simon-staal/Debonair/Energy/README.md

Energy
------

- [**Battery_Charge_Cycle_Logged_SoC**](Battery_Charge_Cycle_Logged_Soc) was used to measure SOC during discharge and charge cycle

- [**multi_Battery**](multi_battery) contains the charging and balancing program that was designed

- The matlab files contain various programs used to obtain graphs using data obtained from experiments

- [**sweep_currents**](sweep_currents) was used to obtain PV and IV curves from the solar panels
