simon-staal/Debonair/Energy/fsm.png

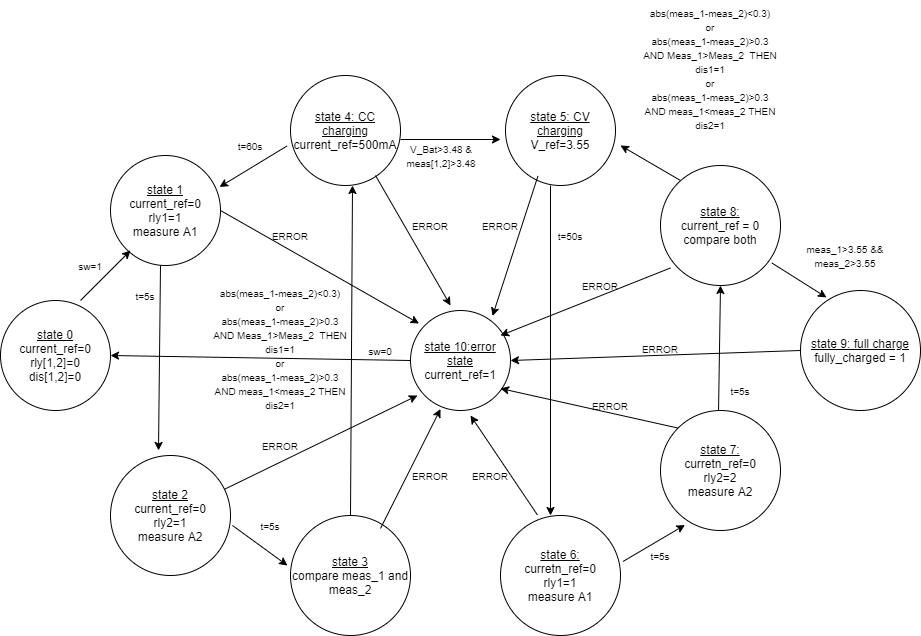
Energy/fsm.png
