simon-staal/Debonair/Front_End/React/web-app/src/components/background.jpg

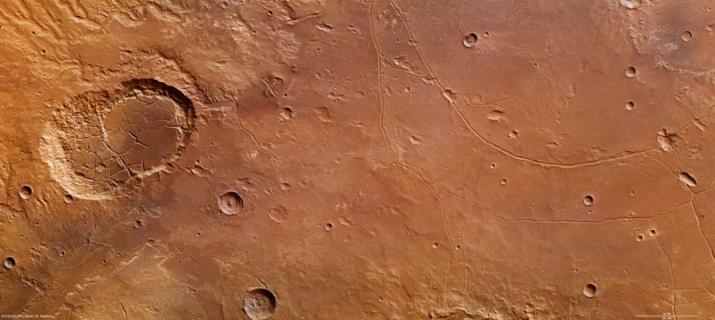
Front_End/React/web-app/src/components/background.jpg
