simon-staal/Debonair/Front_End/React/web-app/src/components/circle.png

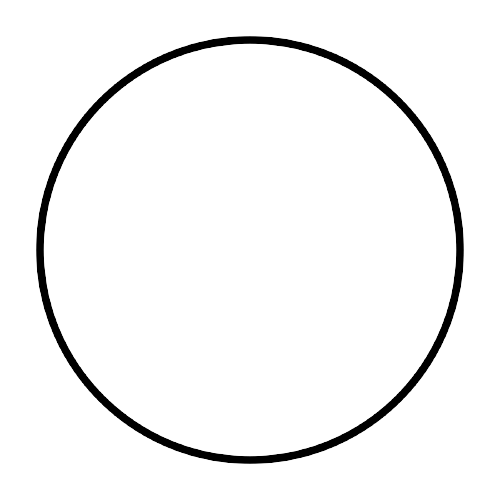
Front_End/React/web-app/src/components/circle.png
