simon-staal/Debonair/Front_End/React/web-app/src/components/grid.png

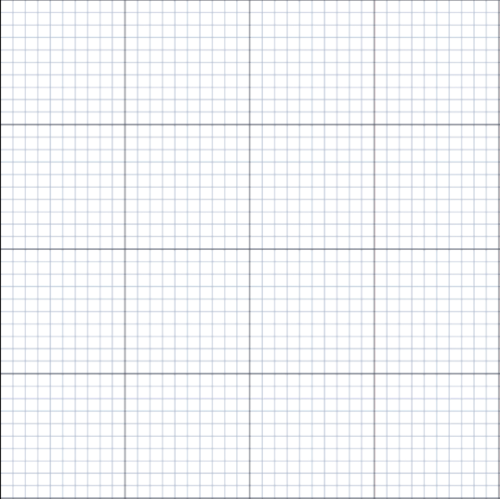
Front_End/React/web-app/src/components/grid.png
