simon-staal/Debonair/Front_End/React/web-app/src/components/grouppic.jpg

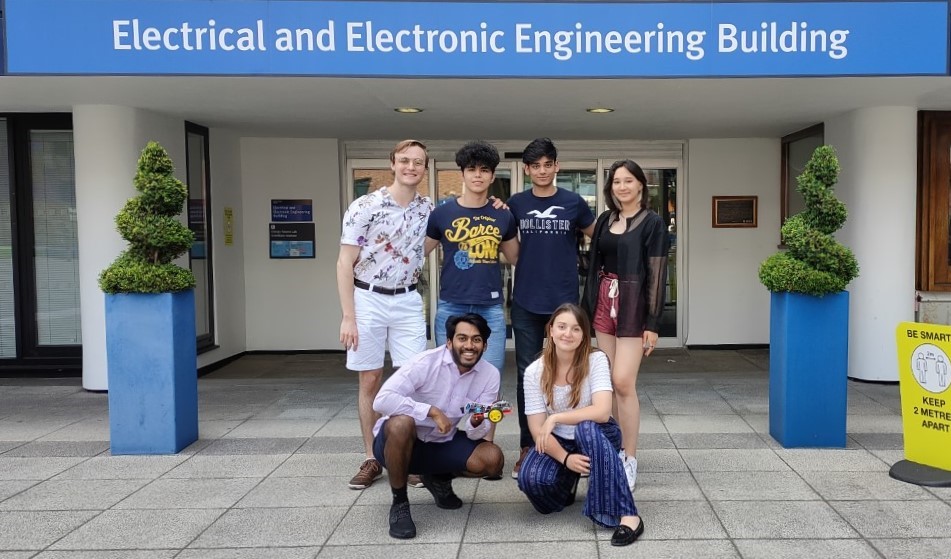
Front_End/React/web-app/src/components/grouppic.jpg
