simon-staal/Debonair/Drive/Rover_rearranged/Rover_rearranged.ino

#include <Wire.h>
#include <INA219_WE.h>
#include "SPI.h"

INA219_WE ina219; // this is the instantiation of the library for the current sensor

// these pins may be different on different boards
// this is for the uno
#define PIN_SS        10
#define PIN_MISO      12
#define PIN_MOSI      11
#define PIN_SCK       13
 
#define PIN_MOUSECAM_RESET     8
#define PIN_MOUSECAM_CS        7

#define ADNS3080_PIXELS_X                 30
#define ADNS3080_PIXELS_Y                 30

#define ADNS3080_PRODUCT_ID            0x00
#define ADNS3080_REVISION_ID           0x01
#define ADNS3080_MOTION                0x02
#define ADNS3080_DELTA_X               0x03
#define ADNS3080_DELTA_Y               0x04
#define ADNS3080_SQUAL                 0x05
#define ADNS3080_PIXEL_SUM             0x06
#define ADNS3080_MAXIMUM_PIXEL         0x07
#define ADNS3080_CONFIGURATION_BITS    0x0a
#define ADNS3080_EXTENDED_CONFIG       0x0b
#define ADNS3080_DATA_OUT_LOWER        0x0c
#define ADNS3080_DATA_OUT_UPPER        0x0d
#define ADNS3080_SHUTTER_LOWER         0x0e
#define ADNS3080_SHUTTER_UPPER         0x0f
#define ADNS3080_FRAME_PERIOD_LOWER    0x10
#define ADNS3080_FRAME_PERIOD_UPPER    0x11
#define ADNS3080_MOTION_CLEAR          0x12
#define ADNS3080_FRAME_CAPTURE         0x13
#define ADNS3080_SROM_ENABLE           0x14
#define ADNS3080_FRAME_PERIOD_MAX_BOUND_LOWER      0x19
#define ADNS3080_FRAME_PERIOD_MAX_BOUND_UPPER      0x1a
#define ADNS3080_FRAME_PERIOD_MIN_BOUND_LOWER      0x1b
#define ADNS3080_FRAME_PERIOD_MIN_BOUND_UPPER      0x1c
#define ADNS3080_SHUTTER_MAX_BOUND_LOWER           0x1e
#define ADNS3080_SHUTTER_MAX_BOUND_UPPER           0x1e
#define ADNS3080_SROM_ID               0x1f
#define ADNS3080_OBSERVATION           0x3d
#define ADNS3080_INVERSE_PRODUCT_ID    0x3f
#define ADNS3080_PIXEL_BURST           0x40
#define ADNS3080_MOTION_BURST          0x50
#define ADNS3080_SROM_LOAD             0x60
#define ADNS3080_PRODUCT_ID_VAL        0x17

float vref; //= 1.5; // value chosen by me

float open_loop, closed_loop; // Duty Cycles
float vpd,vb,iL,dutyref,current_mA; // Measurement Variables // removed vref from this list
unsigned int sensorValue0,sensorValue1,sensorValue2,sensorValue3;  // ADC sample values declaration

float ev=0,cv=0,ei=0,oc=0; //internal signals
float Ts=0.0008; //1.25 kHz control frequency. It's better to design the control period as integral multiple of switching period.

float kpv=0.05024,kiv=15.78,kdv=0; // voltage pid.
float kpi=0.02512,kii=39.4,kdi=0; // current pid.

float u0v,u1v,delta_uv,e0v,e1v,e2v; // u->output; e->error; 0->this time; 1->last time; 2->last last time
float u0i,u1i,delta_ui,e0i,e1i,e2i; // Internal values for the current controller
float uv_max=4, uv_min=0; //anti-windup limitation
float ui_max=1, ui_min=0; //anti-windup limitation
float current_limit = 1.0;
boolean Boost_mode = 0;
boolean CL_mode = 0;

unsigned int loopTrigger;
unsigned int com_count=0;   // a variables to count the interrupts. Used for program debugging.

//************************* PI variables **************************//

float kpDistance = 0.25, kiDistance = 0.58; // coefficient of PI controller
float u0Distance, u1Distance, delta_uDistance, e0Distance, e1Distance, e2Distance;
float cDistance;
float error_y;
float error_angle;

//**************************Communication variables ****************//
char received_char = 'S';
boolean new_data = false;
char last_mov = 'S'; // Tracks last movement (not stop) to deal with sensor delay
char mode = 'M';
char dir = 'S';
int destinationX = 9999;
int destinationY = 9999;
int destinationX_prev;
int destinationY_prev;
long lastMsg = 0;

//************************** Rover Constants / Variables ************************//
  //Measured diameter of Rover complete rotation wrt pivot point positioned on wheel axis: 260 mm
const float pi = 3.14159;
float r = 140.0;

//************************** Motor Constants **************************//
int DIRRstate = LOW;              //initializing direction states
int DIRLstate = HIGH;

int DIRL = 20;                    //defining left direction pin
int DIRR = 21;                    //defining right direction pin

int pwmr = 5;                     //pin to control right wheel speed using pwm
int pwml = 9;                     //pin to control left wheel speed using pwm

//********************** Camera sensor variables ********************//
// NOTE: int is 2 bytes on this thing
int total_x = 0;
int total_y = 0;
int total_x1 = 0;
int total_y1 = 0;
int x=0;
int y=0;
int a=0;
int b=0;
int distance_x=0;
int distance_y=0;
volatile byte movementflag=0;
volatile int xydat[2];
int tdistance = 0;

float dx_mm = 0;
float dy_mm = 0;
//***************************Globals*******************************
float current_angle = 0;
int current_x = 0;
int current_y = 0;

bool destinationreached = false;

//************************ Function declarations *********************//
int convTwosComp(int b);
void mousecam_reset();
int mousecam_init();
void mousecam_write_reg(int reg, int val);
int mousecam_read_reg(int reg);

struct MD
{
 byte motion;
 char dx, dy;
 byte squal;
 word shutter;
 byte max_pix;
};

void mousecam_read_motion(struct MD *p);
int mousecam_frame_capture(byte *pdata);
void sampling(int value);
float saturation( float sat_input, float uplim, float lowlim);
void pwm_modulate(float pwm_input);
float pidv( float pid_input);
float pidi(float pid_input);
void stop_Rover();
void compensate_x(float);
float toDegrees(float angleRadians);
float pidDistance(float pidDistance_input);
bool Turn_PIcontroller(float desired_angle, float dy_val, float dx_val, float *current_ang);
bool move_PIcontroller(int desired_x, int desired_y);
void sendcoords(int x_coord_send, int y_coord_send, float angle_send);
void sendDone();
void TurnLeft_PIcontroller(float desired_angle);

//*************************** Setup ****************************//

void setup() {
  // Camera Pins Defining: 
  pinMode(PIN_SS,OUTPUT);
  pinMode(PIN_MISO,INPUT);
  pinMode(PIN_MOSI,OUTPUT);
  pinMode(PIN_SCK,OUTPUT);
  
  SPI.begin();
  SPI.setClockDivider(SPI_CLOCK_DIV32);
  SPI.setDataMode(SPI_MODE3);
  SPI.setBitOrder(MSBFIRST);
  
  Serial.begin(38400);
  
  // Communication with ESP32
  Serial1.begin(9600);

  if(mousecam_init()==-1)
  {
    Serial.println("Mouse cam failed to init");
    while(1);
  }

  // Motor Pins Defining: 
  pinMode(DIRR, OUTPUT);
  pinMode(DIRL, OUTPUT);
  pinMode(pwmr, OUTPUT);          //pin to control right wheel speed using pwm - pwmr is pin 5
  pinMode(pwml, OUTPUT);          //pin to control left wheel speed using pwm - pwml is pin 9
  
  digitalWrite(pwmr, HIGH);       //setting right motor speed at maximum
  digitalWrite(pwml, HIGH);       //setting left motor speed at maximum

  // Basic pin setups:
  noInterrupts(); //disable all interrupts
  pinMode(13, OUTPUT);  //Pin13 is used to time the loops of the controller
  pinMode(3, INPUT_PULLUP); //Pin3 is the input from the Buck/Boost switch
  pinMode(2, INPUT_PULLUP); // Pin 2 is the input from the CL/OL switch
  analogReference(EXTERNAL); // We are using an external analogue reference for the ADC

  //*************** TimerA0 initialization for control-loop interrupt.***********//
  
  TCA0.SINGLE.PER = 999; //
  TCA0.SINGLE.CMP1 = 999; //
  TCA0.SINGLE.CTRLA = TCA_SINGLE_CLKSEL_DIV16_gc | TCA_SINGLE_ENABLE_bm; //16 prescaler, 1M.
  TCA0.SINGLE.INTCTRL = TCA_SINGLE_CMP1_bm; 
  
  //********************** TimerB0 initialization for PWM output ****************//
  
  pinMode(6, OUTPUT);
  TCB0.CTRLA =TCB_CLKSEL_CLKDIV1_gc | TCB_ENABLE_bm; //62.5kHz
  analogWrite(6,120); 

  interrupts();  //enable interrupts.
  Wire.begin(); // We need this for the i2c comms for the current sensor
  ina219.init(); // this initiates the current sensor
  Wire.setClock(700000); // set the comms speed for i2c
  sampling(1000);
}

//***************************** Loop **************************//

void loop() {
  
  // main code here runs repeatedly:
  //******************** Communication part: ****************
  if (Serial1.available()) {
    received_char = Serial1.read();
    // Updates mode (C = coordinate, M = controlled by ESP)
    if (received_char == 'C' || received_char == 'M') {
      mode = received_char;
    }
    // If in controlled mode, updates direction
    if (mode == 'M') {
      dir = received_char;
    }
    // If in coordinate mode, updates destination
    if (mode == 'C' && received_char == '<') {
      String x = Serial1.readStringUntil(',');
      String y = Serial1.readStringUntil('>');
      destinationX_prev = destinationX;
      destinationY_prev = destinationY;
      destinationX = x.toInt();
      destinationY = y.toInt();
    }
  }

//******************* Camera loop part: ********************//

  #if 0
    /*
        if(movementflag){
        tdistance = tdistance + convTwosComp(xydat[0]);
        Serial.println("Distance = " + String(tdistance));
        movementflag=0;
        delay(3);
        }
      */
    // if enabled this section grabs frames and outputs them as ascii art  
    if(mousecam_frame_capture(frame)==0)
    {
      int i,j,k;
      for(i=0, k=0; i<ADNS3080_PIXELS_Y; i++) 
      {
        for(j=0; j<ADNS3080_PIXELS_X; j++, k++) 
        {
          Serial.print(asciiart(frame[k]));
          Serial.print(' ');
        }
        Serial.println();
      }
    }
    Serial.println();
    delay(250);
  
  #else
  
    // if enabled this section produces a bar graph of the surface quality that can be used to focus the camera
    // also drawn is the average pixel value 0-63 and the shutter speed and the motion dx,dy.
  
    int val = mousecam_read_reg(ADNS3080_PIXEL_SUM);
    MD md;
    mousecam_read_motion(&md);
    for(int i=0; i<md.squal/4; i++) {
      Serial.print('*');
    }
    Serial.print(' ');
    Serial.print((val*100)/351);
    Serial.print(' ');
    Serial.print(md.shutter); Serial.print(" (");
    Serial.print((int)md.dx); Serial.print(',');
    Serial.print((int)md.dy); Serial.println(')');

    // Serial.println(md.max_pix);
    delay(100);
    
    distance_x = md.dx; //convTwosComp(md.dx);
    distance_y = md.dy; //convTwosComp(md.dy);

    total_x1 = (total_x1 + distance_x);
    total_y1 = (total_y1 + distance_y);

    total_x = (float)(total_x1/157.0) * 10; //Conversion from counts per inch to mm (400 counts per inch)
    total_y = (float)(total_y1/157.0) * 10; //Conversion from counts per inch to mm (400 counts per inch)

    //defined by me
    dx_mm = (float)(distance_x/157.0) * 10;
    dy_mm = (float)(distance_y/157.0) * 10;

    Serial.print('\n');
      Serial.println("dx = "+String(distance_x));
    Serial.println("dy = "+String(distance_y));

    Serial.println("Distance_x = " + String(total_x));
    Serial.println("Distance_y = " + String(total_y));
    Serial.print('\n');
    Serial.println("dx (mm) = "+String(dx_mm));
    Serial.println("dy (mm) = "+String(dy_mm));

    delay(100);
  #endif

  //************************** Motor Loop part: ****************************//
  if (loopTrigger) { // This loop is triggered, it wont run unless there is an interrupt
    digitalWrite(13, HIGH);   // set pin 13. Pin13 shows the time consumed by each control cycle. It's used for debugging.

    // Sample all of the measurements and check which control mode we are in
    sampling(1000);
    CL_mode = digitalRead(3); // input from the OL_CL switch
    Boost_mode = digitalRead(2); // input from the Buck_Boost switch
      
    if (!Boost_mode && CL_mode) { // Closed Loop Buck
        // The closed loop path has a voltage controller cascaded with a current controller. The voltage controller
        // creates a current demand based upon the voltage error. This demand is saturated to give current limiting.
        // The current loop then gives a duty cycle demand based upon the error between demanded current and measured
        // current
        current_limit = 3; // Buck has a higher current limit
        ev = vref - vb;  //voltage error at this time
        cv=pidv(ev);  //voltage pid
        cv=saturation(cv, current_limit, 0); //current demand saturation
        ei=cv-iL; //current error
        closed_loop=pidi(ei);  //current pid
        closed_loop=saturation(closed_loop,0.99,0.01);  //duty_cycle saturation
        pwm_modulate(closed_loop); //pwm modulation - closed_loop is a duty      
    }
    digitalWrite(13, LOW);   // reset pin13.
    loopTrigger = 0;
  }

 
  //************************** Rover Modes of Operation **************************//
  
  //unsigned long now = millis();

  // REMOTE CONTROLLER MODE: DIRECT INPUT FROM USER 
  // AND
  // EXPLORE MODE - like REMOTE CONTROLLER BUT THE COMMANDS COME FROM VISION

  Serial.println("mode = "+ String(mode));
  if(mode == 'M'){
    digitalWrite(pwmr, HIGH);       //setting right motor speed at maximum
    digitalWrite(pwml, HIGH);       //setting left motor speed at maximum
    
    if(dir == 'F'){
      DIRRstate = LOW;   //goes forwards
      DIRLstate = HIGH;
      Serial.println(dir);
    }
    else if(dir == 'B'){
      DIRRstate = HIGH;   //goes backwards
      DIRLstate = LOW;     
      Serial.println(dir);
    }
    else if(dir == 'L'){
      DIRRstate = LOW;   // turns left - rotates anticlockwise
      DIRLstate = LOW;
      Serial.println(dir);
    }
    else if(received_char == 'R'){
      DIRRstate = HIGH;   // turns right - rotates clockwise
      DIRLstate = HIGH;
      Serial.println(dir);
    }
    else if(dir == 'S'){
      pwm_modulate(0);
      //stop_Rover();
      Serial.println(dir);
    } // stops
    else{
      pwm_modulate(0);
      //stop_Rover();
      Serial.println("default stop");
      Serial.println(dir);
    } // by default stop 

    digitalWrite(DIRR, DIRRstate);
    digitalWrite(DIRL, DIRLstate);

    ////////////////////////////////////////////////////////////////////////////////

    Serial.println("dy_mm is " + String(dy_mm));
    Serial.println("dx_mm is " + String(dx_mm));
    if(abs(dy_mm) > abs(4*dx_mm)){
      float measuredDistance = sqrt(pow(dy_mm,2) + pow(dx_mm,2));
      int ispositive = (dy_mm > 0) ? 1 : -1;
      current_y = current_y + (measuredDistance * ispositive) * cos(current_angle);
      current_x = current_x + (measuredDistance * ispositive) * sin(current_angle);
    }
    else{
      float measuredDistance = sqrt(pow(dy_mm,2) + pow(dx_mm,2));
      float alpha = asin(measuredDistance/(2*r)) * 2 ; 
      current_angle = (dx_mm < 0) ? (current_angle + alpha) : (current_angle - alpha); // calculate angle rotated by the small incremental change first
      current_angle = (current_angle > 3.14159265359) ? (current_angle - 3.14159265359) : current_angle;    
      current_angle = (current_angle < -3.14159265359) ? (current_angle + 3.14159265359): current_angle;  //used to change angle if it goes above 180 degrees / below -180 degrees  
    }

     ///////////////////////////////////////////////////////////////////////////////
    // Sends info back to ESP
    unsigned long now = millis();
    if (now - lastMsg > 200) { // Sends info every 200 ms
      Serial.println("Last message: " + String(lastMsg));
      Serial.println("Current time: " + String(now));
      lastMsg = now;
      sendcoords(current_x, current_y, toDegrees(current_angle)); // Sends info to ESP
    } 
  }

  
  //**************************************************************************
  // COORDINATE MODE: REACHING SET OF COORDINATES SET BY THE USER

  if(mode == 'C'){
    destinationreached = (destinationX != destinationX_prev || destinationY != destinationY_prev) ? false : destinationreached;
    Serial.println("We are in coordinate mode"); 
    if (destinationX > 1000 || destinationY > 1000 ) {
        Serial.println("We are not moving");
        stop_Rover();
      //pwm_modulate(0);
    }
    else{
        digitalWrite(pwmr, HIGH);
        digitalWrite(pwml, HIGH);
        float changeinx = destinationX - current_x;
        float changeiny = destinationY - current_y;
        //first we rotate
        Serial.println("dy_mm before the loop is " + String(dy_mm) + "dx_mm before the loop is " + String(dx_mm));
        Serial.println("more debugging, x and y are " + String(distance_x) + "," + String(distance_y));
        bool not_turning;
        if(changeinx > 0 && changeiny > 0){ 
            not_turning = Turn_PIcontroller(toDegrees(atan(changeinx/changeiny)), dy_mm, dx_mm, &current_angle);            //top right quadrant
        }
        else if (changeinx > 0 && changeiny < 0){
            not_turning = Turn_PIcontroller(toDegrees(atan(-changeiny/changeinx)) + 90, dy_mm, dx_mm, &current_angle);      //bottom right quadrant
        }
        else if (changeinx < 0 && changeiny > 0){
            not_turning = Turn_PIcontroller(toDegrees(-changeinx/changeiny), dy_mm, dx_mm, &current_angle);                 //top left quadrant
        }
        else if(changeinx < 0 && changeiny < 0){
            not_turning = Turn_PIcontroller(toDegrees(atan(-changeiny/-changeinx)) - 90, dy_mm, dx_mm, &current_angle);     //bottom left quadrant
        }

        //end of rotation functions

        //start of movement forward/backwards functions
        if(not_turning && !destinationreached){
            destinationreached = move_PIcontroller(destinationX, destinationY);     //bottom left quadrant
            if(destinationreached){
                destinationX = 9999;
                destinationY = 9999;
            }
        }

       unsigned long now = millis();
       if (now - lastMsg > 200) { // Sends info every 200 ms
          Serial.println("Last message: " + String(lastMsg));
          Serial.println("Current time: " + String(now));
          lastMsg = now;
          sendcoords(current_x, current_y, toDegrees(current_angle)); // Sends info to ESP
       }

        //end of movement forward/backward functions
        
    }
  }
}

//*************************** Loop end ***********************

// Timer A CMP1 interrupt. Every 800us the program enters this interrupt. 
// This, clears the incoming interrupt flag and triggers the main loop.

ISR(TCA0_CMP1_vect){
  TCA0.SINGLE.INTFLAGS |= TCA_SINGLE_CMP1_bm; //clear interrupt flag
  loopTrigger = 1;
}

//************************** Functions ***************************************//

int convTwosComp(int b){
  //Convert from 2's complement
  if(b & 0x80){
    b = -1 * ((b ^ 0xff) + 1);
    }
  return b;
  }

void mousecam_reset(){
  digitalWrite(PIN_MOUSECAM_RESET,HIGH);
  delay(1); // reset pulse >10us
  digitalWrite(PIN_MOUSECAM_RESET,LOW);
  delay(35); // 35ms from reset to functional
}

int mousecam_init(){
  pinMode(PIN_MOUSECAM_RESET,OUTPUT);
  pinMode(PIN_MOUSECAM_CS,OUTPUT);
  
  digitalWrite(PIN_MOUSECAM_CS,HIGH);
  
  mousecam_reset();
  
  int pid = mousecam_read_reg(ADNS3080_PRODUCT_ID);
  if(pid != ADNS3080_PRODUCT_ID_VAL)
    return -1;

  // turn on sensitive mode
  mousecam_write_reg(ADNS3080_CONFIGURATION_BITS, 0x19);

  return 0;
 }

void mousecam_write_reg(int reg, int val){
  digitalWrite(PIN_MOUSECAM_CS, LOW);
  SPI.transfer(reg | 0x80);
  SPI.transfer(val);
  digitalWrite(PIN_MOUSECAM_CS,HIGH);
  delayMicroseconds(50);
}

int mousecam_read_reg(int reg){
  digitalWrite(PIN_MOUSECAM_CS, LOW);
  SPI.transfer(reg);
  delayMicroseconds(75);
  int ret = SPI.transfer(0xff);
  digitalWrite(PIN_MOUSECAM_CS,HIGH); 
  delayMicroseconds(1);
  return ret;
}

void mousecam_read_motion(struct MD *p){
  digitalWrite(PIN_MOUSECAM_CS, LOW);
  SPI.transfer(ADNS3080_MOTION_BURST);
  delayMicroseconds(75);
  p->motion =  SPI.transfer(0xff);
  p->dx =  SPI.transfer(0xff);
  p->dy =  SPI.transfer(0xff);
  p->squal =  SPI.transfer(0xff);
  p->shutter =  SPI.transfer(0xff)<<8;
  p->shutter |=  SPI.transfer(0xff);
  p->max_pix =  SPI.transfer(0xff);
  digitalWrite(PIN_MOUSECAM_CS,HIGH); 
  delayMicroseconds(5);
}

int mousecam_frame_capture(byte *pdata){            // pdata must point to an array of size ADNS3080_PIXELS_X x ADNS3080_PIXELS_Y
  mousecam_write_reg(ADNS3080_FRAME_CAPTURE,0x83);  // you must call mousecam_reset() after this if you want to go back to normal operation
  
  digitalWrite(PIN_MOUSECAM_CS, LOW);
  SPI.transfer(ADNS3080_PIXEL_BURST);
  delayMicroseconds(50);
  
  int pix;
  byte started = 0;
  int count;
  int timeout = 0;
  int ret = 0;
  for(count = 0; count < ADNS3080_PIXELS_X * ADNS3080_PIXELS_Y; ){
    pix = SPI.transfer(0xff);
    delayMicroseconds(10);
    if(started==0){
      if(pix&0x40)
        started = 1;
      else{
        timeout++;
        if(timeout==100){
          ret = -1;
          break;
        }
      }
    }
    if(started==1){
     pdata[count++] = (pix & 0x3f)<<2; // scale to normal greyscale byte range
     }
  }
  digitalWrite(PIN_MOUSECAM_CS,HIGH); 
  delayMicroseconds(14);
  return ret;
}

void sampling(int value){

  // Make the initial sampling operations for the circuit measurements
  
  sensorValue0 = analogRead(A0); //sample Vb
  sensorValue2 = value; //sample Vref
 // sensorValue2 = vref *(1023.0/ 4.096);  
  sensorValue3 = analogRead(A3); //sample Vpd
  current_mA = ina219.getCurrent_mA(); // sample the inductor current (via the sensor chip)
  
  /* Process the values so they are a bit more usable/readable
     The analogRead process gives a value between 0 and 1023 
     representing a voltage between 0 and the analogue reference which is 4.096V
  */
  //sensorValue2 = 500;
  vb = sensorValue0 * (4.096 / 1023.0); // Convert the Vb sensor reading to volts
  vref = sensorValue2 * (4.096 / 1023.0); // Convert the Vref sensor reading to volts
  // now vref is set at the top of the code
  //sensorValue2 = vref *(1023.0/ 4.096);
  vpd = sensorValue3 * (4.096 / 1023.0); // Convert the Vpd sensor reading to volts

 /* The inductor current is in mA from the sensor so we need to convert to amps.
    We want to treat it as an input current in the Boost, so its also inverted
    For open loop control the duty cycle reference is calculated from the sensor
    differently from the Vref, this time scaled between zero and 1.
    The boost duty cycle needs to be saturated with a 0.33 minimum to prevent high output voltages
 */ 
  if (Boost_mode == 1){
    iL = -current_mA/1000.0;
    dutyref = saturation(sensorValue2 * (1.0 / 1023.0),0.99,0.33);
  }else{
    iL = current_mA/1000.0;
    dutyref = sensorValue2 * (1.0 / 1023.0);
  } 
}

float saturation(float sat_input, float uplim, float lowlim){ // Saturation function
  if (sat_input > uplim) sat_input=uplim;
  else if (sat_input < lowlim ) sat_input=lowlim;
  else;
  return sat_input;
}

void pwm_modulate(float pwm_input){ // PWM function
  analogWrite(6,(int)(255-pwm_input*255)); 
}

// This is a PID controller for the voltage
float pidv( float pid_input){
  float e_integration;
  e0v = pid_input;
  e_integration = e0v;
 
  //anti-windup, if last-time pid output reaches the limitation, this time there won't be any intergrations.
  if(u1v >= uv_max) {
    e_integration = 0;
  } else if (u1v <= uv_min) {
    e_integration = 0;
  }

  delta_uv = kpv*(e0v-e1v) + kiv*Ts*e_integration + kdv/Ts*(e0v-2*e1v+e2v); //incremental PID programming avoids integrations.there is another PID program called positional PID.
  u0v = u1v + delta_uv;  //this time's control output

  //output limitation
  saturation(u0v,uv_max,uv_min);
  
  u1v = u0v; //update last time's control output
  e2v = e1v; //update last last time's error
  e1v = e0v; // update last time's error
  return u0v;
}

// This is a PID controller for the current
float pidi(float pid_input){
  float e_integration;
  e0i = pid_input;
  e_integration=e0i;
  
  //anti-windup
  if(u1i >= ui_max){
    e_integration = 0;
  } else if (u1i <= ui_min) {
    e_integration = 0;
  }
  
  delta_ui = kpi*(e0i-e1i) + kii*Ts*e_integration + kdi/Ts*(e0i-2*e1i+e2i); //incremental PID programming avoids integrations.
  u0i = u1i + delta_ui;  //this time's control output

  //output limitation
  saturation(u0i,ui_max,ui_min);
  
  u1i = u0i; //update last time's control output
  e2i = e1i; //update last last time's error
  e1i = e0i; // update last time's error
  return u0i;
}

//PI controller for the Distance
float pidDistance(float pidDistance_input) {

  float e_integration;
  e0Distance = pidDistance_input;
  e_integration = e0Distance;

  delta_uDistance = kpDistance * (e0Distance - e1Distance) + kiDistance * Ts * e_integration; // incremental PI avoids integrations
  u0Distance = u1Distance + delta_uDistance;  // this time's control output

  u1Distance = u0Distance;  // update last time's control output
  e2Distance = e1Distance;  // update last last time's error -->> not in use in this PI
  e1Distance = e0Distance;  // update last time's error

  return u0Distance;
  
}

bool Turn_PIcontroller(float desired_angle, float dy_val, float dx_val, float *current_ang) {
    Serial.println("Desiredangle should have been 45 but is " + String(desired_angle));
    Serial.println("dy_val is " + String(dy_val) + "dx_val is " + String(dx_val));
    float error_angle = desired_angle - toDegrees(current_angle);
    float cDistance = pidDistance(error_angle);
    if(error_angle < -10 || error_angle > 10){
      pwm_modulate(abs(cDistance)*0.01+0.3);
    }
    else if(error_angle < -5 || error_angle > 5){
      pwm_modulate(0.3);
    }
    else{
      pwm_modulate(0.25);
    }
    if (abs(error_angle) >= 1 && error_angle <= -1){
      DIRRstate = LOW;   // turns left - rotates anticlockwise
      DIRLstate = LOW;
    }
    else if (abs(error_angle) >= 1 && error_angle >= 1){
      DIRRstate = HIGH;   // turns right - rotates clockwise
      DIRLstate = HIGH;
    }
    else{
      return true;
    }
    digitalWrite(DIRR, DIRRstate);
    digitalWrite(DIRL, DIRLstate);

    float measuredDistance = sqrt(pow(dy_val,2) + pow(dx_val,2));
    float alpha = asin(measuredDistance/(2*r)) * 2 ; 
    float angleval = *current_ang;
    angleval = (dx_val < 0) ? (angleval + alpha) : (angleval - alpha); // calculate angle rotated by the small incremental change first
    angleval = (angleval > 3.14159265359) ? (angleval - 3.14159265359) : angleval;
    angleval = (angleval < -3.14159265359) ? (angleval + 3.14159265359) : angleval;  //used to change angle if it goes above 180 degrees / below -180 degrees 
    Serial.println("current angle is " + String(toDegrees(angleval))); 
    *current_ang = angleval;
    return false;
}

bool move_PIcontroller(int desired_x, int desired_y) {
  Serial.print("ENTERING DISTANCE MOVEMENT FORWARD");
  float error_distance = sqrt(pow((current_x-desired_x),2) + pow((current_y-desired_y),2));
  bool forward = (((current_y + error_distance * cos(current_angle) < desired_y + 5) && (current_y + error_distance * cos(current_angle) > desired_y - 5))) ? true : false;
  float cDistance = pidDistance(error_distance);
  Serial.println("error distance is " + String(error_distance));
  if(error_distance > 30){
    pwm_modulate(abs(cDistance)*0.01+0.6);
    Serial.print("Modulating it to 0.6");
  } 
  else if(error_distance > 10){
    pwm_modulate(0.45);
    Serial.print("Modulating it to 0.45");
  }
  else{
    pwm_modulate(0.35);
    Serial.print("Modulating it to 0.35");
  }
  if(error_distance > 5 && forward){
      DIRRstate = LOW;   //goes forwards
      DIRLstate = HIGH;
  }
  else if(error_distance > 5 && !forward){
        DIRRstate = HIGH;   //goes backwards
        DIRLstate = LOW; 
  }
  else{
    stop_Rover();
    return true;
  }
  digitalWrite(DIRR, DIRRstate);
  digitalWrite(DIRL, DIRLstate);

  float measuredDistance = sqrt(pow(dy_mm,2) + pow(dx_mm,2)); 
  current_y = current_y + measuredDistance * cos(current_angle);
  current_x = current_x + measuredDistance * sin(current_angle);
  return false;
}

void stop_Rover(){
  digitalWrite(pwmr, LOW);
  digitalWrite(pwml, LOW);
  //pwm_modulate(0);
  Serial.println("Stop function activated");
}

float toDegrees(float angleRadians){
  return (angleRadians/pi)*180;
}

void sendcoords(int x_coord_send, int y_coord_send, float angle_send){
  String toESP;
  toESP += '<';
  toESP += String(x_coord_send);
  toESP += ',';
  toESP += String(y_coord_send);
  toESP += ',';
  toESP += String((int)angle_send);
  toESP += '>';
  Serial1.print(toESP);
  Serial.println("Sending: "+toESP);
}

void sendDone(){
  Serial1.print('P');
}

/*end of the program.*/
