simon-staal/Debonair/Control/Comms/char_tests/ESP32_to_nano/single_char/nano_single_receive_char_test.ino

char received_char;
boolean new_data = false;

void setup() {
  // put your setup code here, to run once:
  Serial.begin(115200);
  Serial1.begin(9600);

}

void loop() {
  // put your main code here, to run repeatedly:
  rec_one_char();
  show_new_data();
    
}

void rec_one_char() {
  if(Serial1.available()){
    received_char = Serial1.read();
    new_data = true;
  }
}

void show_new_data() {
  if(new_data == true) {
    Serial.print("An ");
    Serial.print(received_char);
    Serial.println(" has arrived");
    new_data = false;
  }
  
}
