simon-staal/Debonair/(commit log)

2021-05-19 Arduino requests folder..
2021-05-20 successful tuning of Motor speed
    yay
    By setting vref at the top of the code (in the range 0-5V) it is now possible to alter the speed of the motors.
2021-05-21 Working mqtt client for the esp32, capable to send an receive information to our broker
    [mqtt_client_esp32.ino]
2021-05-21 Big progress on mqtt esp32 client + broker, now requires authentication, everything still working
    [mqtt_client_esp32.ino]
2021-05-26 Comms examples added
    All examples for communication between ESP32 and nano for single/multiple ints and chars added.
2021-05-26 Updated esp32 client to use encryption
2021-05-26 Updated button communication
2021-05-26 Working on implementing mqtts client on esp32
2021-05-26 Updated broker settings to allow unencrypted communication, can't get it working on the rover
    [mqtt_client_esp32.ino]
2021-05-31 Remote functionality working correctly!
    Tested the remote functionality of the rover together with the ESP32
    [Rover_rearranged.ino]
2021-06-01 Working on Coordinate Mode
    Changes needed to the Coordinate Mode because the sensor perceives as the y axis the direction in which the front of the rover points =>coordinate system of the Rover changes with its movement
2021-06-01 Fixed Coordinate mode & structured 3-mode operation
    note: still need to implement obstacle avoidance for coordinate mode
    [Rover_rearranged.ino]
2021-06-04 Working with ruwan on pathfinding, can avoid single obstacle
    [mqtt_client_esp32.ino]
2021-06-05 SPI done with arduino code + rover instructions
2021-06-06 Working on comms between backend and esp32
2021-06-07 Prepped esp32 for rover coords sending test
2021-06-07 REST updating rover position from ESP32
2021-06-07 Added database debugging + working on ESP32
2021-06-07 Updated obstacle communication between server and ESP32
2021-06-08 Refactored SPI code, want khayle to test
2021-06-08 updated print. It works!!!!!!
2021-06-08 Programs ESP32
2021-06-08 I want to die
2021-06-10 Updated ESP32 to receive destination coords from frontend
2021-06-13 adjusted coordinate mode + fixed sending part
    [Rover_rearranged.ino]
2021-06-13 Updated ESP32 to receive packet from drive, made drive send packets every 200ms
2021-06-15 Updated REST API to handle power stuff
2021-06-15 Updated ESP32 to use UART parsing method from Drive_sts
2021-06-15 new distance calc fixed
    [Rover_rearranged.ino, mqtt_client_esp32.ino]
2021-06-16 energy stuff
    [multi_1.CSV, pv stuff.xlsx]
2021-06-16 Updated API to change battery
2021-06-16 Battery functionality updated
2021-06-16 esp32 updated
2021-06-17 Repository almost staged for submission
2021-06-17 Staged Drive for submission
2021-06-18 Updated for battery highlight
2021-06-18 Error handling to battery
2021-06-18 Solved battery bug
